Cytkit/cytkit/build_instructions/electronics1s1f.md

# Electronics: Cytkit model 1S-1F

## Mount FSC detector  {pagestep}

## Mount PMT detector {pagestep}

## LED flash calibration tool {pagestep}

## Sample pump stepper motor controller {pagestep}

## Sheath pump DC motor controller {pagestep}

## PMT power supply {pagestep}

## Picoscope {pagestep}

*** pic after set-up
