Cytkit/cytkit/build_instructions/electronics2s14f.md

# Electronics: Cytkit model 2S-14F

## FSC and SSC detectors  {pagestep}

## SiPM array (fluorescence) detector {pagestep}

## LED flash calibration tool {pagestep}

## Front panel OLED display {pagestep}

## Interlocks and connector boards {pagestep}

## Main board {pagestep}

## Power supply and USB connector {pagestep}

*** pics after set-up
