Cytkit/cytkit/build_instructions/images/build diagrams/optics/main body with optics - 1s1f.png

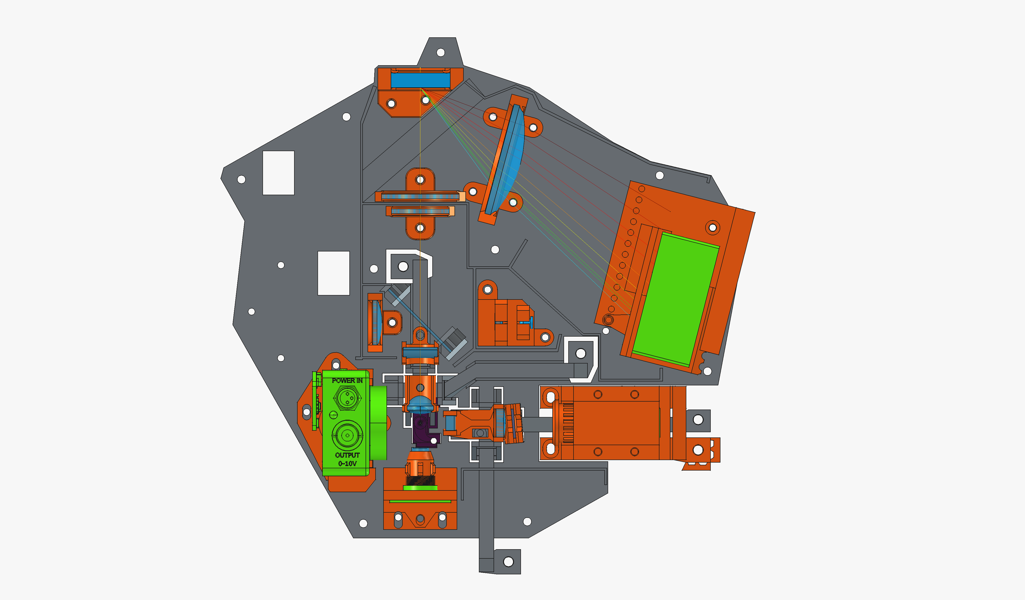
build_instructions/images/build diagrams/optics/main body with optics - 1s1f.png
