Cytkit/cytkit/build_instructions/images/build diagrams/optics/main body with optics - 2s14f - perspective2.png

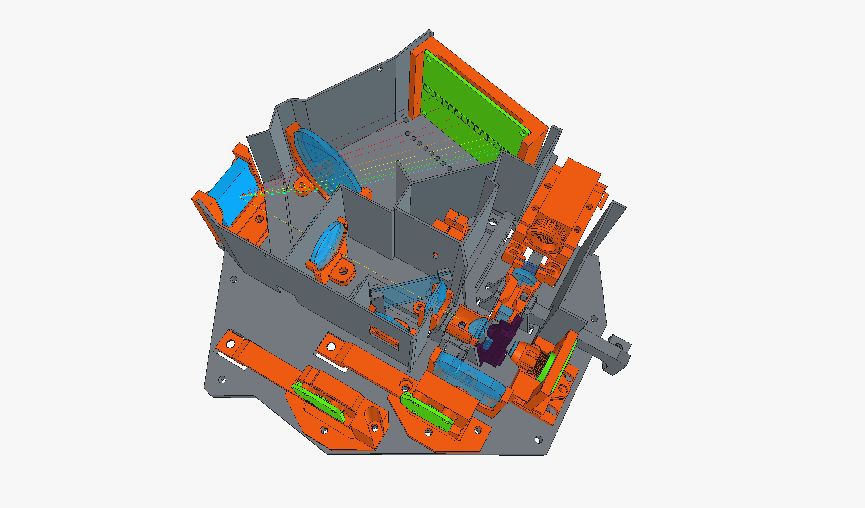
build_instructions/images/build diagrams/optics/main body with optics - 2s14f - perspective2.png
