Cytkit/cytkit/build_instructions/images/build diagrams/optics/main body with optics - 2s14f - without main body.png

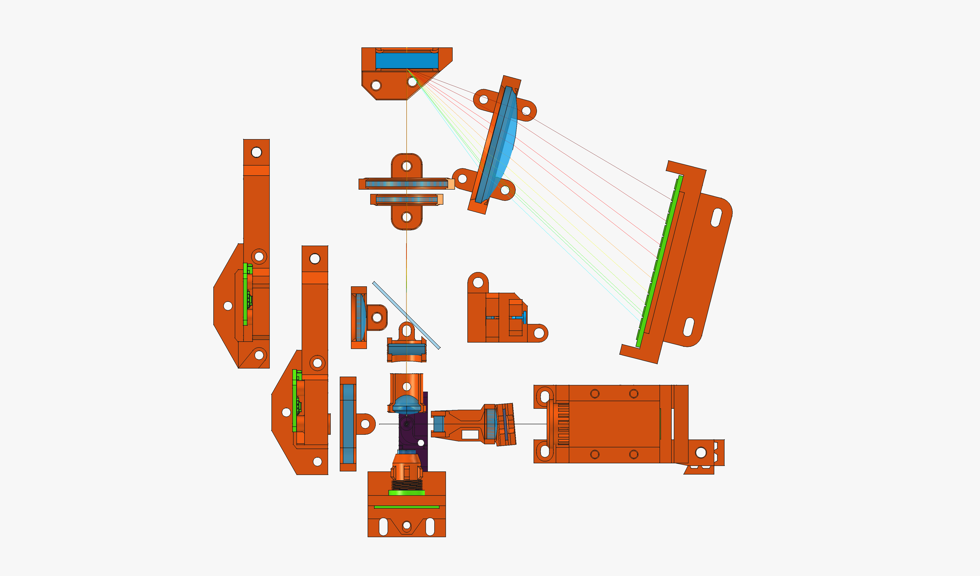
build_instructions/images/build diagrams/optics/main body with optics - 2s14f - without main body.png
