Cytkit/cytkit/build_instructions/images/build diagrams/optics/main body with optics - 2s14f.png

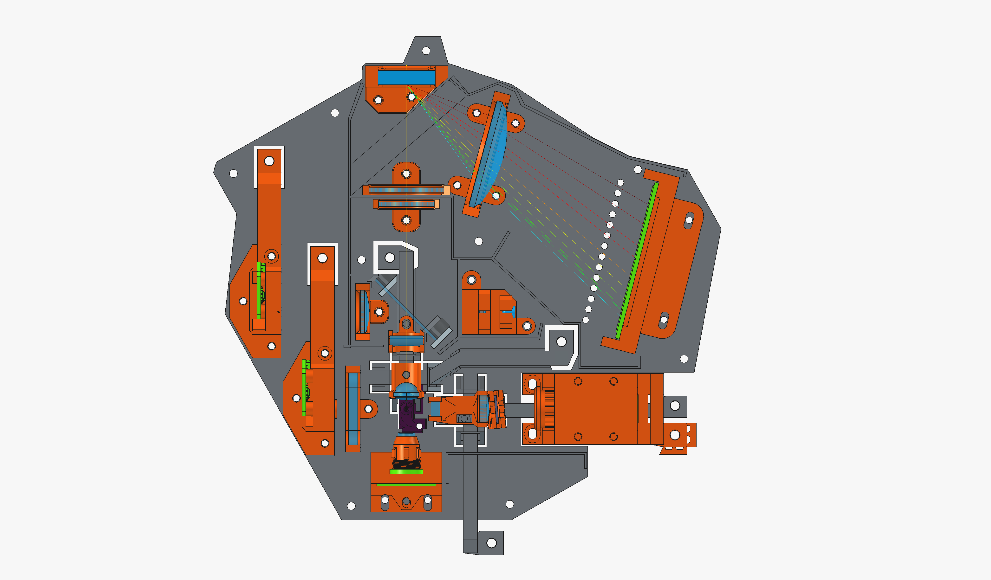
build_instructions/images/build diagrams/optics/main body with optics - 2s14f.png
