Cytkit/cytkit/build_instructions/printed/stl/main body with optics-fsc v slit 4mm.stl

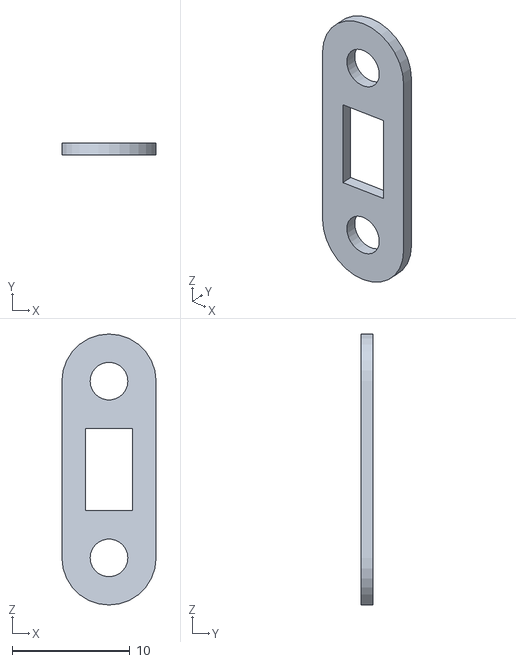
[picture p5: CAD file, 2026-11-09]
build_instructions/printed/stl/main body with optics-fsc v slit 4mm.stl
8.00 x 1.00 x 23.0
