Cytkit/cytkit/CAD and optical model/main body with optics.FCStd

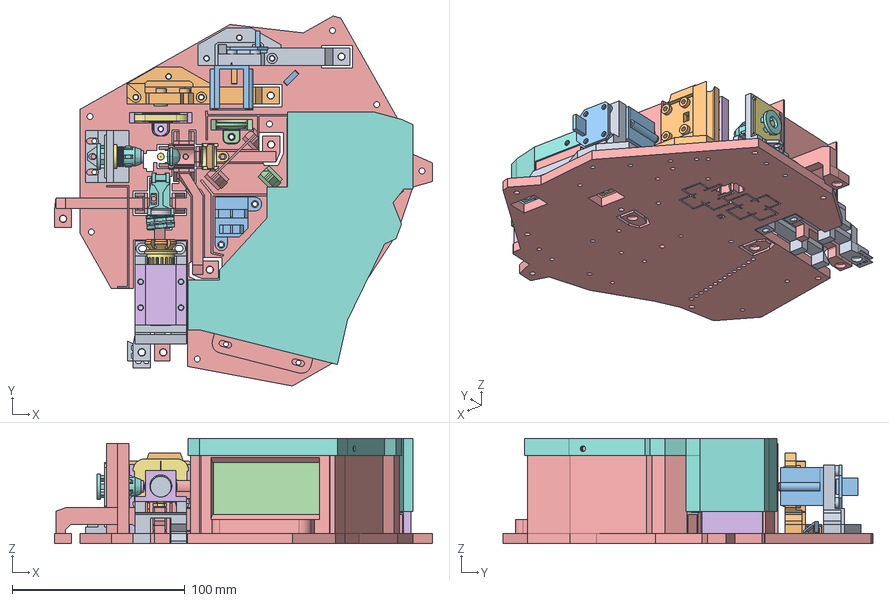
[picture p6: CAD file, 2026-11-09]
CAD and optical model/main body with optics.FCStd
219.1 x 214.4 x 61.0 mm
laser
Spectrum foc lens
Grating cube
PCB placeholder
laser collmating lens C775TMD-A - f = 4.0 mm, NA = 0.60, WD = 1.5 mm, Mounted Aspheric Lens, ARC: 350 - 700 nm
water
capillary quartz 4mm (round)
12X6mm Plano Convex Cylindrical Lens K9 Optical Glass Focal Length 27mm Center Thickness 4mm
Fused Silica 12.7mm Diameter Optical Plano Convex Lens Focal Length 50
corr cyl lens glass
SSC board
ssc foc lens f=50mm
dichroic filter 1
fsc foc lens aspherical od7
gopro filter
F8D12.7 aspherical condensing lens ACL 12708U CTN002243-E0W
bandpass
cable stay
cable stay 2
dichroic holder 2a
Main body
laser heat sink
lock nut
focusing lens holders
ssc holder
PD holder v adjust h slit
fsc h slit
fsc v slit 0.4mm
condensing lens holder
filter holder for fsc
corr cyl lens holder
fluorescence compartment cap
Holder Laser 25mW
colimating lens adjustment tool - short
LED holder for FL+SSC testing
ssc foc lens holder
Holder FL board - extra airflow to rear
Holder grating
Holder spec foc lens
Filter holder D34mm
Filter holder D25mm
Filter holder double D15mm
ssc h bar holder
ssc hbar 2mm
ssc hbar 1mm
ssc hbar 3mm
camera OV9726 25x30mm module
camera lens tube
camera focus mount - v adjust 2
