Cytkit/cytkit/build_instructions/printed/stl/main body with optics-Filter holder double D15mm.stl

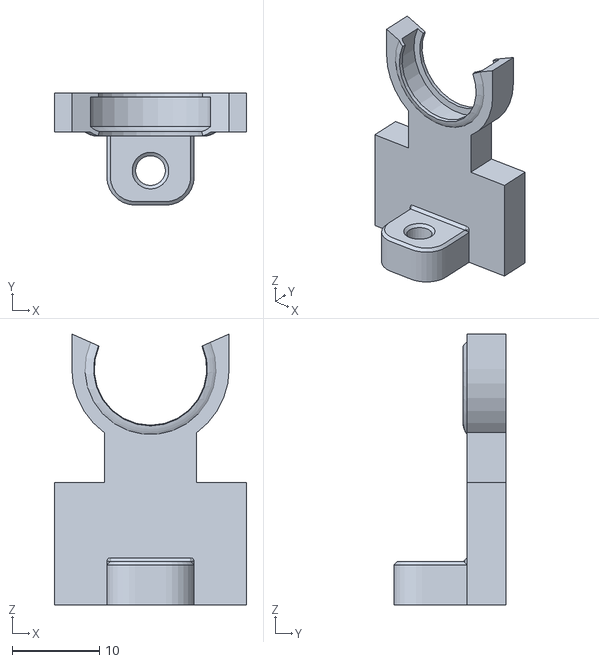
[picture p7: CAD file, 2026-11-09]
build_instructions/printed/stl/main body with optics-Filter holder double D15mm.stl
22.0 x 12.8 x 31.0
