Cytkit/cytkit/build_instructions/printed/stl/main body with optics-fsc v slit 2mm.stl

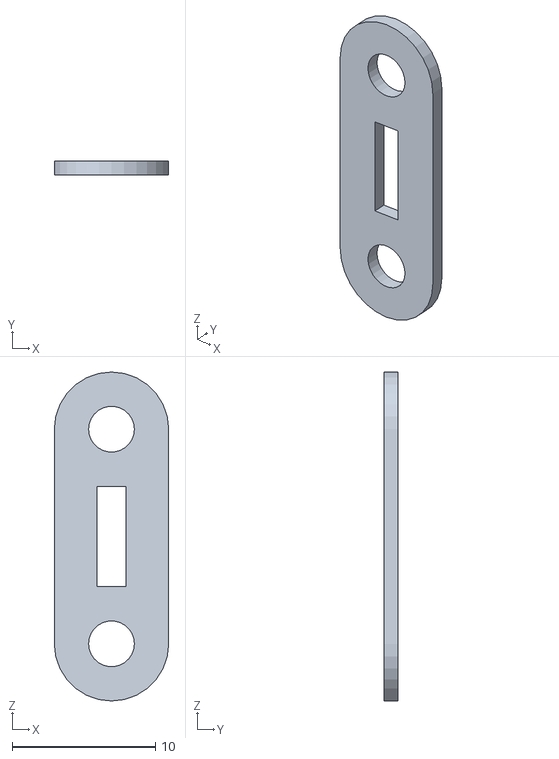
[picture p8: CAD file, 2026-11-09]
build_instructions/printed/stl/main body with optics-fsc v slit 2mm.stl
8.00 x 1.00 x 23.0
