Cytkit/cytkit/CAD and optical model/base panel cover stand cart.FCStd

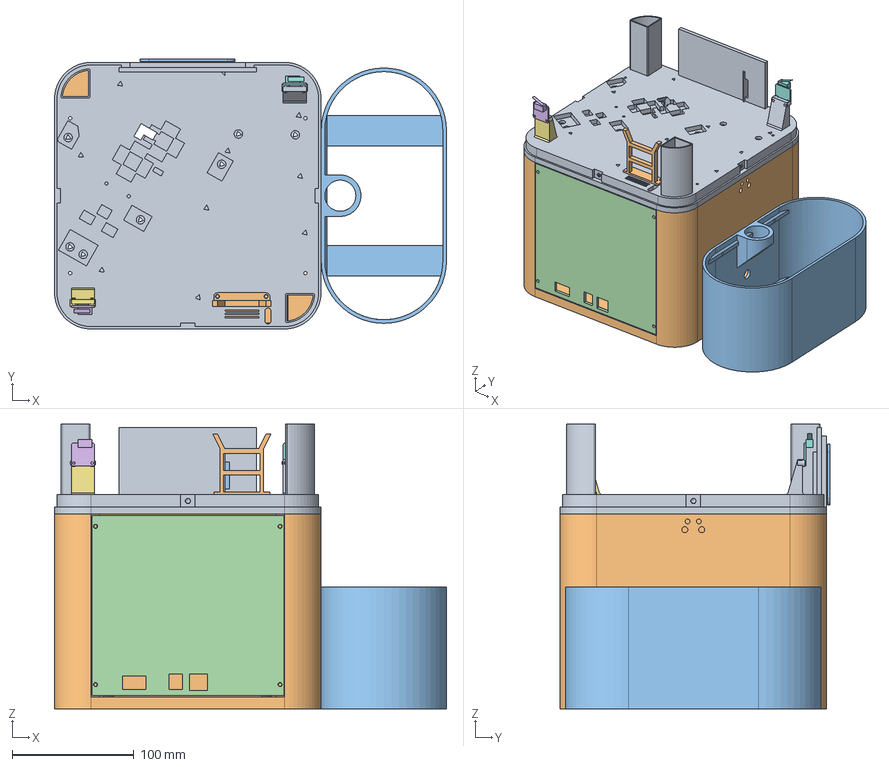
[picture p9: CAD file, 2026-11-09]
CAD and optical model/base panel cover stand cart.FCStd
322.0 x 221.8 x 234.0 mm
Base
Stand
Fluidics cart
rear panel
peristaltic pump holder flexi
interlock
interlock holder
interlock2
interlock holder 2
cable stay bar
Logo front panel
