Cytkit/cytkit/(list of files, cad)

Other CAD files:
CAD and optical model/Cytkit master assembly.FCStd
CAD and optical model/sample loader assembled.FCStd
