Cytkit/cytkit/build_instructions/fluidic/o-rings.md

---
PartData:
    Specs:
        Material: Nitrile (black)
        ID: 1 mm
        CS: 1 mm
    Suppliers:
        Seals R Us on eBay:
            PartNo: N/A
            Link: 'https://www.ebay.co.uk/itm/363833117691?var=633860823996'
---
# O-Rings (Nitrile, Black)

For sealing flow cell against cuvette on both ends.
