Cytkit/cytkit/build_instructions/images/build diagrams/optics/focus lens holder assembly.png

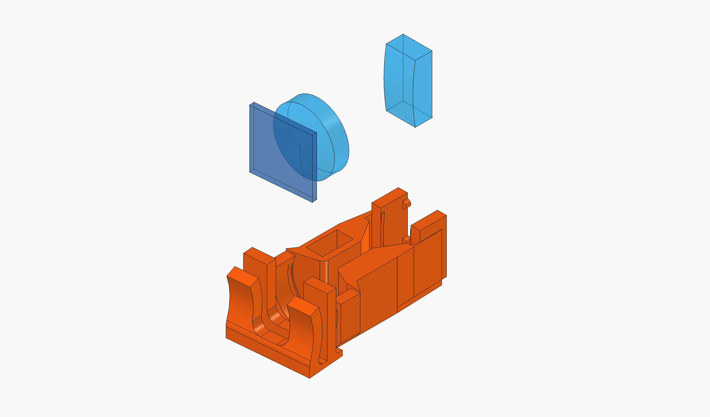
build_instructions/images/build diagrams/optics/focus lens holder assembly.png
