Cytkit/cytkit/build_instructions/images/build diagrams/optics/fsc detector assembly.png

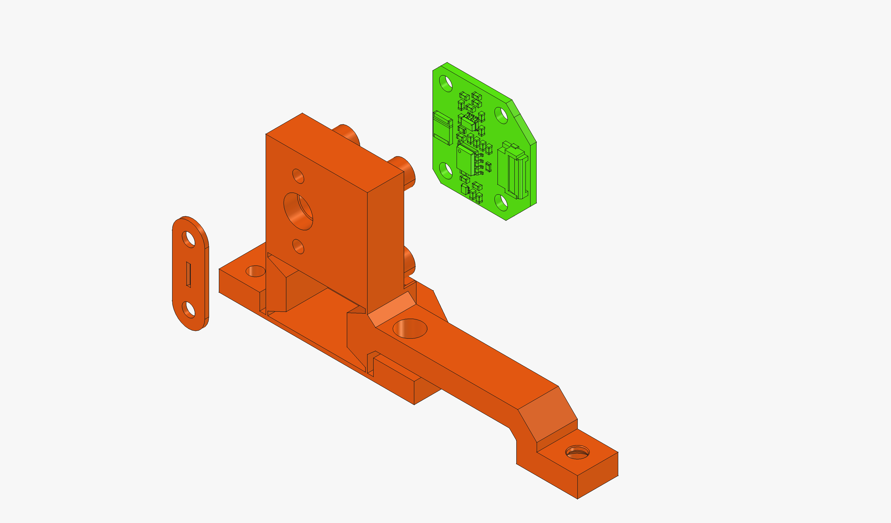
build_instructions/images/build diagrams/optics/fsc detector assembly.png
