Cytkit/cytkit/build_instructions/images/build diagrams/optics/laser assembly.png

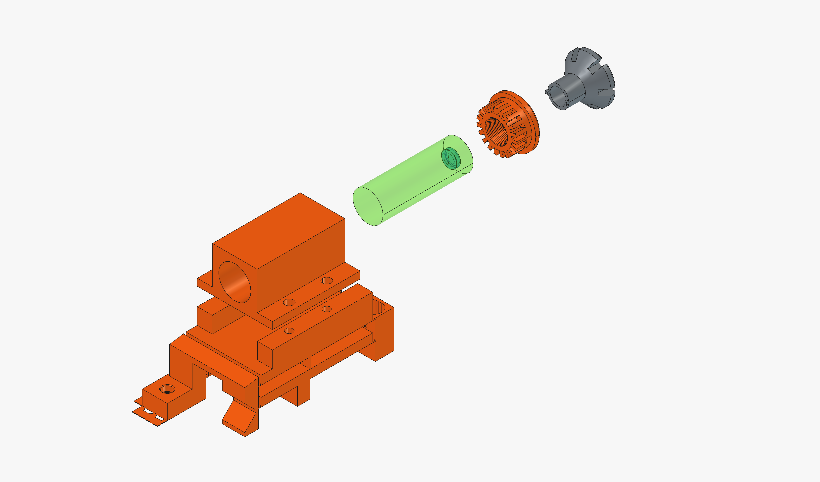
build_instructions/images/build diagrams/optics/laser assembly.png
