Cytkit/cytkit/build_instructions/images/build diagrams/optics/led flasher assembly.png

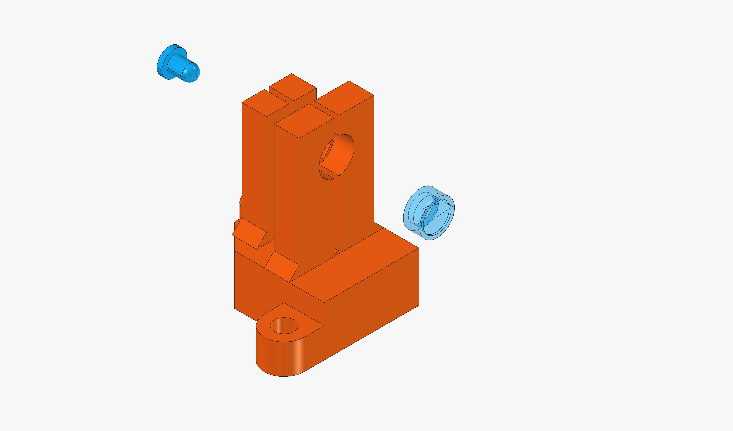
build_instructions/images/build diagrams/optics/led flasher assembly.png
