Cytkit/cytkit/build_instructions/images/build diagrams/optics/sipm detector assembly.png

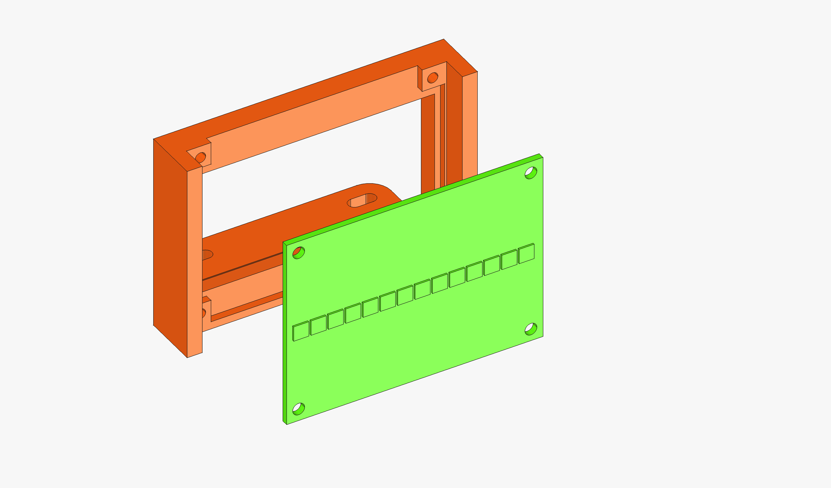
build_instructions/images/build diagrams/optics/sipm detector assembly.png
