Cytkit/cytkit/build_instructions/images/build diagrams/optics/ssc detector assembly.png

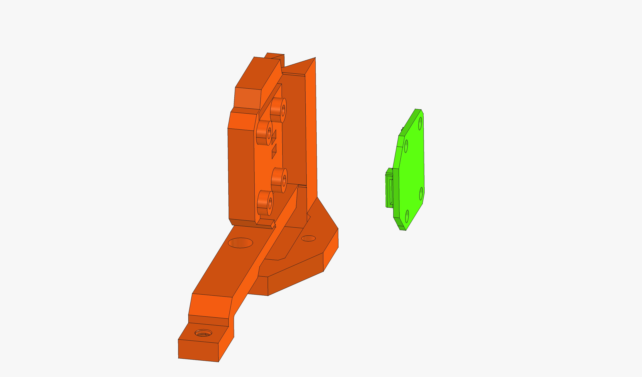
build_instructions/images/build diagrams/optics/ssc detector assembly.png
