Cytkit/cytkit/build_instructions/images/build photos/more photos/20260530_124508.jpg

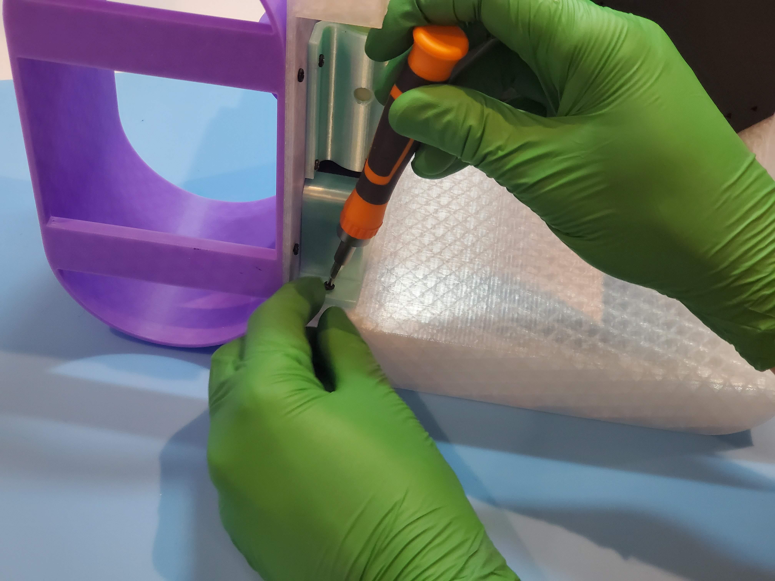
build_instructions/images/build photos/more photos/20260530_124508.jpg
