Cytkit/cytkit/build_instructions/images/build photos/more photos/20260530_144437.jpg

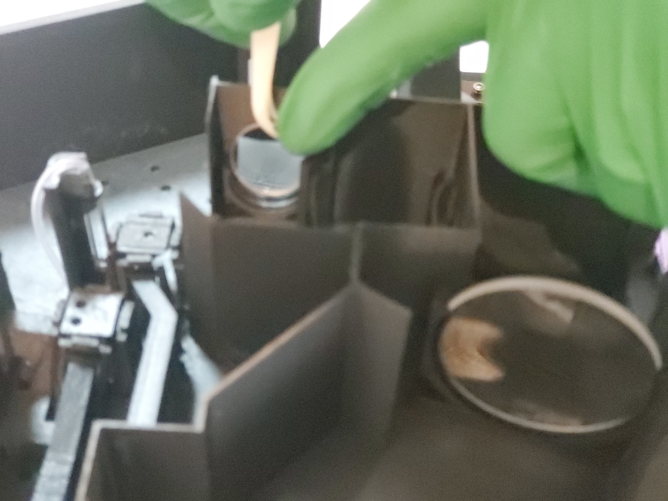
build_instructions/images/build photos/more photos/20260530_144437.jpg
