Cytkit/cytkit/build_instructions/images/build photos/more photos/20260530_145707.jpg

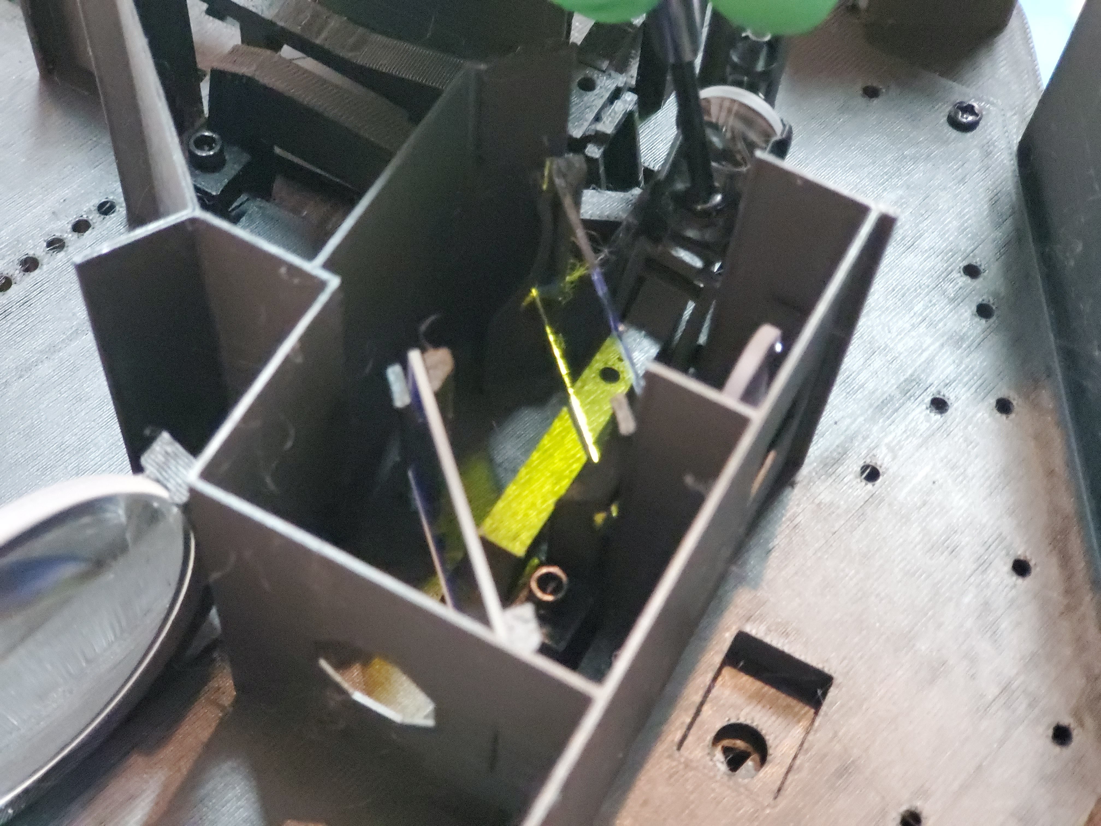
build_instructions/images/build photos/more photos/20260530_145707.jpg
