Cytkit/cytkit/build_instructions/images/build photos/more photos/20260530_151049.jpg

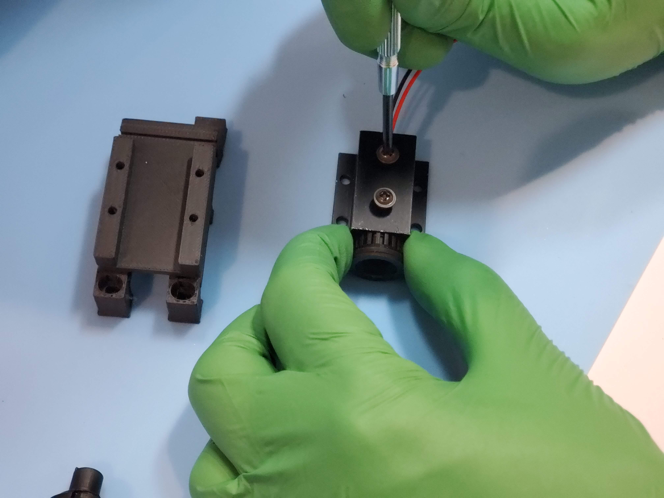
build_instructions/images/build photos/more photos/20260530_151049.jpg
