Cytkit/cytkit/build_instructions/images/build photos/more photos/20260530_152505.jpg

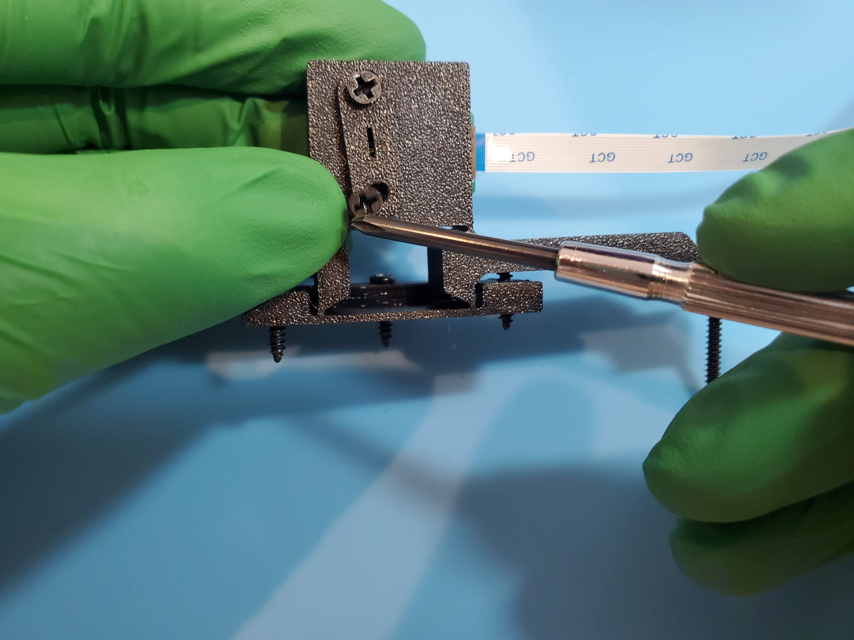
build_instructions/images/build photos/more photos/20260530_152505.jpg
