Cytkit/cytkit/build_instructions/images/build photos/more photos/20260530_154637.jpg

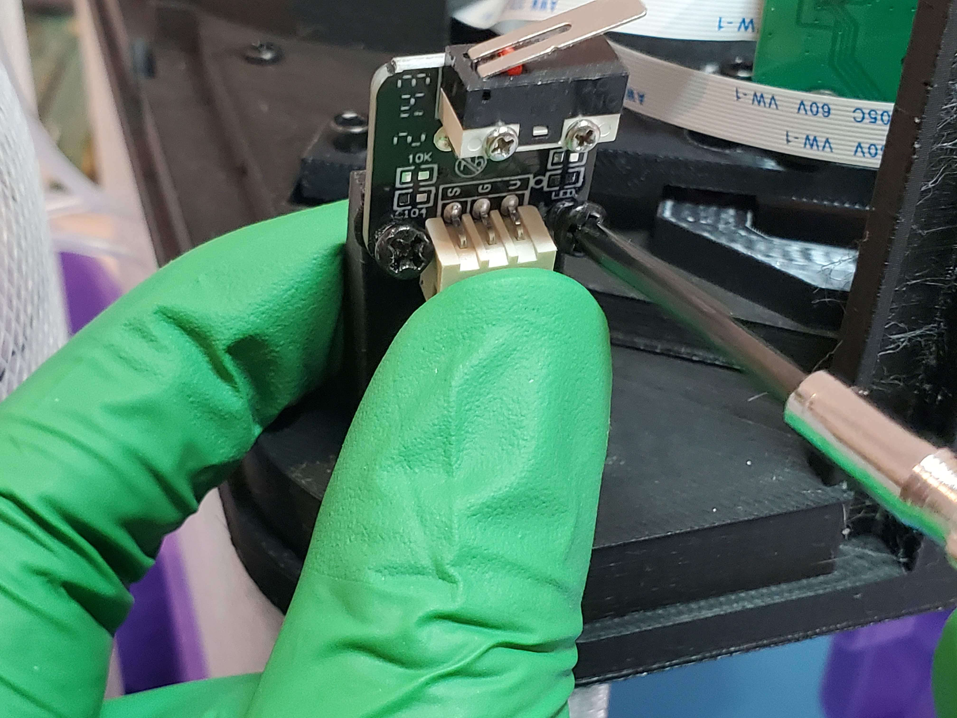
build_instructions/images/build photos/more photos/20260530_154637.jpg
