Cytkit/cytkit/build_instructions/images/build photos/more photos/20260530_172929.jpg

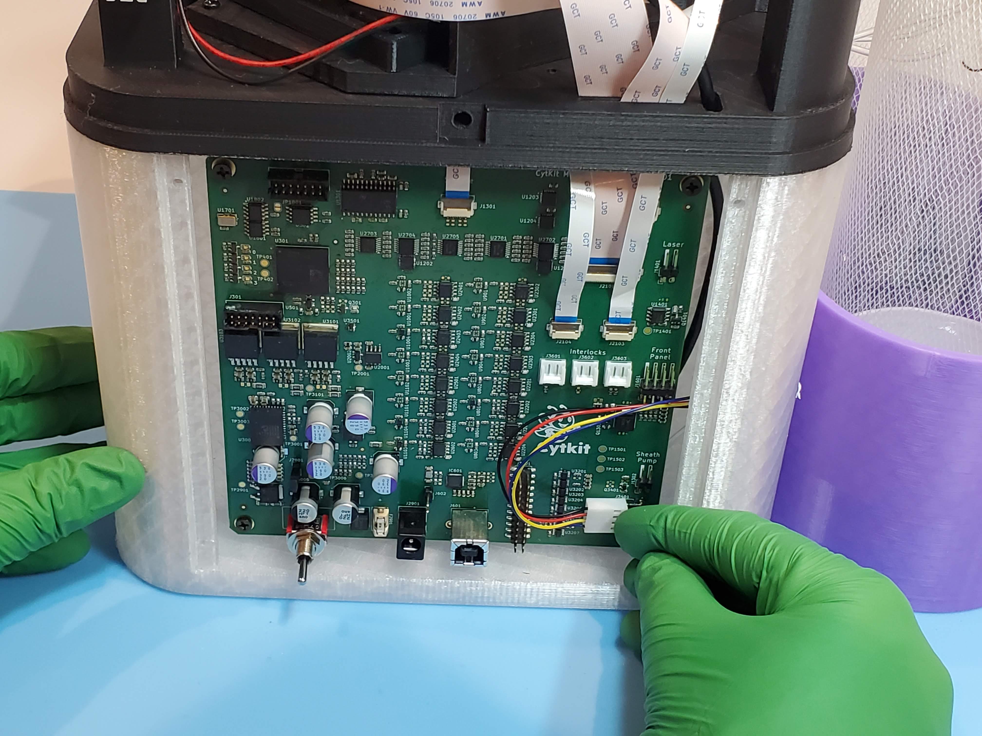
build_instructions/images/build photos/more photos/20260530_172929.jpg
