Cytkit/cytkit/build_instructions/images/build photos/more photos/20260530_173735.jpg

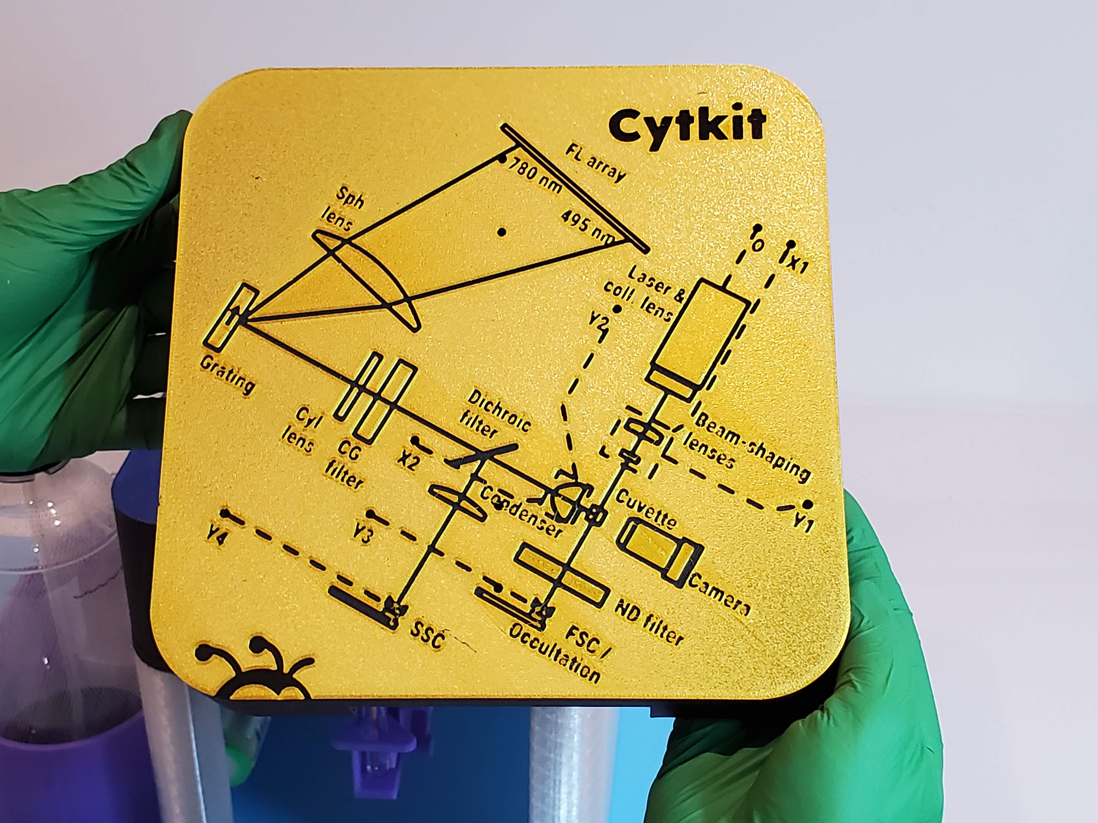
build_instructions/images/build photos/more photos/20260530_173735.jpg
