Cytkit/cytkit/build_instructions/images/build photos/more photos/20260530_181712.jpg

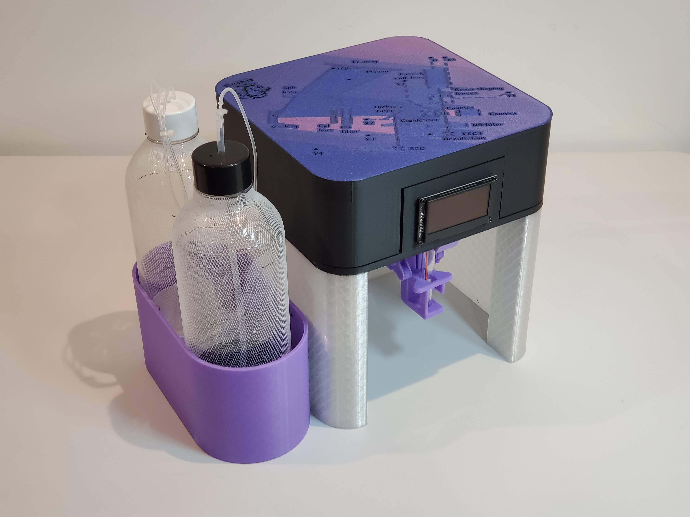
build_instructions/images/build photos/more photos/20260530_181712.jpg
