Cytkit/cytkit/build_instructions/images/build photos/more photos/20260531_122913.jpg

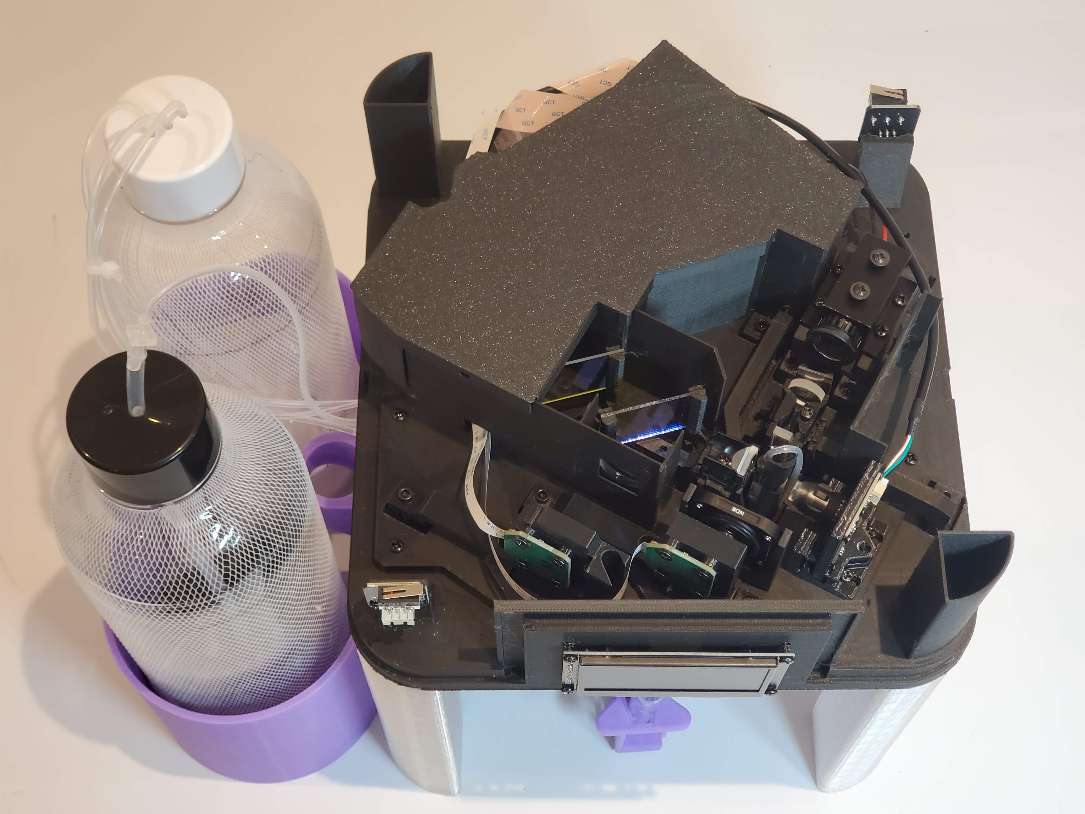
build_instructions/images/build photos/more photos/20260531_122913.jpg
