Cytkit/cytkit/build_instructions/images/build photos/more photos/20260531_122926.jpg

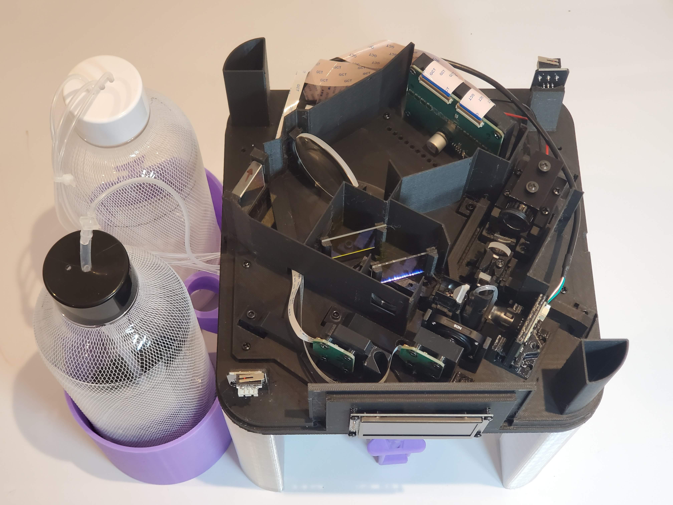
build_instructions/images/build photos/more photos/20260531_122926.jpg
