Cytkit/cytkit/build_instructions/images/build photos/more photos/20260531_170930.jpg

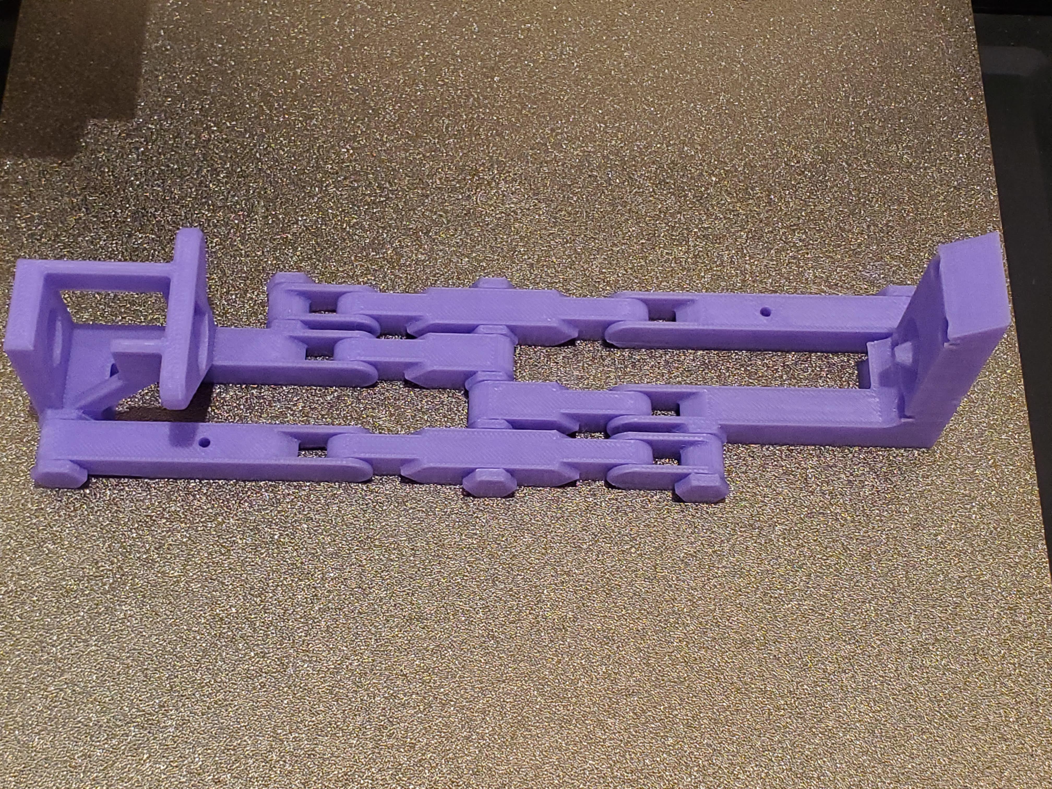
build_instructions/images/build photos/more photos/20260531_170930.jpg
