Cytkit/cytkit/build_instructions/images/build photos/more photos/20260602_085630.jpg

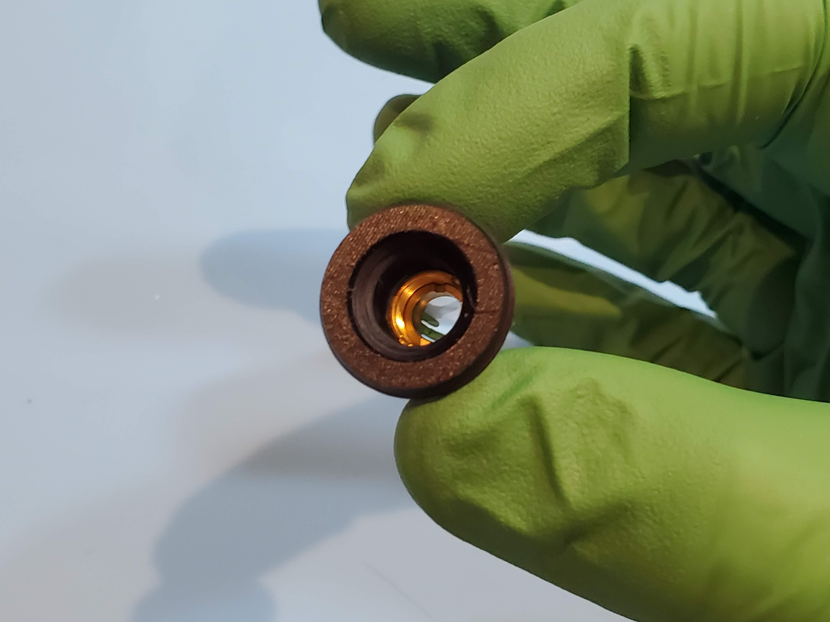
build_instructions/images/build photos/more photos/20260602_085630.jpg
