Cytkit/cytkit/build_instructions/images/build photos/more photos/20260602_085747.jpg

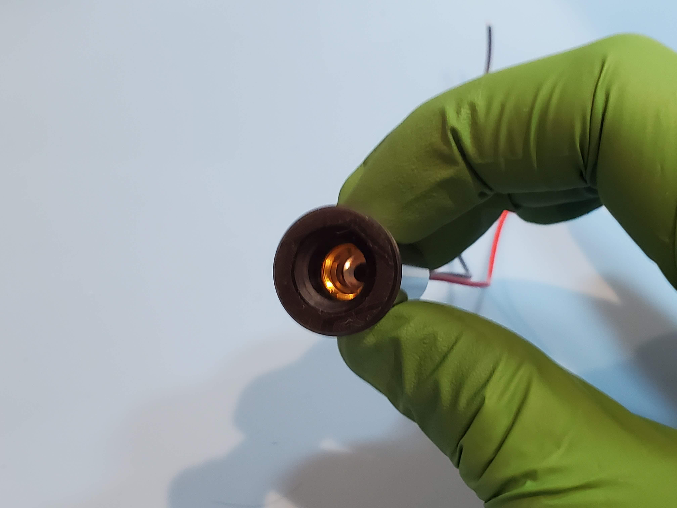
build_instructions/images/build photos/more photos/20260602_085747.jpg
