Cytkit/cytkit/build_instructions/images/build photos/more photos/20260928_152339.jpg

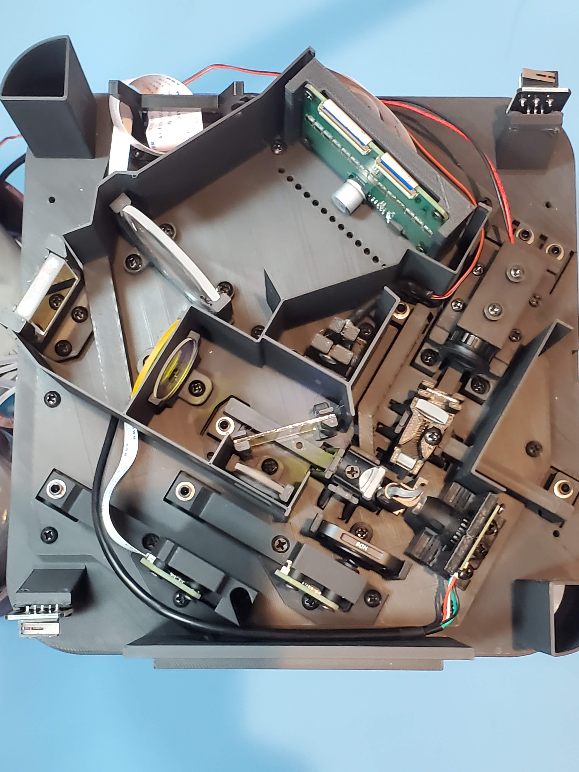
build_instructions/images/build photos/more photos/20260928_152339.jpg
