Cytkit/cytkit/build_instructions/mechanical/screws.yaml

self_tapping_m3x25_hex_socket:
    Name: M3 self-tapping hex socket cap screws 25 mm (black)
    Description: Metric Screw
    Specs:
        Material: Carbon Steel (Black)
        Thread: M3
        Length: 25 mm
        Cap: internal hex cap (Allen key)
    Suppliers:
        Aliexpress:
            PartNo: 15-50pcs Black Hex Hexagon Socket Cap Head Self Tapping Screws Carbon Steel
            Link: 'https://www.aliexpress.com/item/1005004723738740.html'
self_tapping_m3x6_posi:
    Name: M3 self-tapping posi head screws 6 mm (black)
    Description: Metric Screw
    Specs:
        Material: Carbon Steel (Black)
        Thread: M3
        Length: 6 mm
        Cap: Philips/Posi
    Suppliers:
        Aliexpress:
            PartNo: Black Carbon Steel Phillips Truss Head Screw
            Link: 'https://www.aliexpress.com/item/1005009495394483.html'
self_tapping_m3x8_posi:
    Name: M3 self-tapping posi head screws 8 mm (black)
    Description: Metric Screw
    Specs:
        Material: Carbon Steel (Black)
        Thread: M3
        Length: 8 mm
        Cap: Philips/Posi
    Suppliers:
        Aliexpress:
            PartNo: Black Carbon Steel Phillips Truss Head Screw
            Link: 'https://www.aliexpress.com/item/1005009495394483.html'
self_tapping_m3x10_posi:
    Name: M3 self-tapping posi head screws 10 mm (black)
    Description: Metric Screw
    Specs:
        Material: Carbon Steel (Black)
        Thread: M3
        Length: 10 mm
        Cap: Philips/Posi
    Suppliers:
        Aliexpress:
            PartNo: Black Carbon Steel Phillips Truss Head Screw
            Link: 'https://www.aliexpress.com/item/1005009495394483.html'
self_tapping_m3x12_posi:
    Name: M3 self-tapping posi head screws 12 mm (black)
    Description: Metric Screw
    Specs:
        Material: Carbon Steel (Black)
        Thread: M3
        Length: 12 mm
        Cap: Philips/Posi
    Suppliers:
        Aliexpress:
            PartNo: Black Carbon Steel Phillips Truss Head Screw
            Link: 'https://www.aliexpress.com/item/1005009495394483.html'
self_tapping_m3x16_posi:
    Name: M3 self-tapping posi head screws 16 mm (black)
    Description: Metric Screw
    Specs:
        Material: Carbon Steel (Black)
        Thread: M3
        Length: 16 mm
        Cap: Philips/Posi
    Suppliers:
        Aliexpress:
            PartNo: Black Carbon Steel Phillips Truss Head Screw
            Link: 'https://www.aliexpress.com/item/1005009495394483.html'
self_tapping_m2.6x6_posi:
    Name: M2.6 self-tapping posi head screws 6 mm (black)
    Description: Metric Screw
    Specs:
        Material: Carbon Steel (Black)
        Thread: M2.6
        Length: 6 mm
        Cap: Philips/Posi
    Suppliers:
        Aliexpress:
            PartNo: Black Carbon Steel Phillips Truss Head Screw
            Link: 'https://www.aliexpress.com/item/1005009495394483.html'
m3_washers:
    Name: M3 washers
    Description: Metric washer
    Specs:
        Material: Stainless Steel
        Inner diameter: 3 mm
        Cap: Philips/Posi
    Suppliers:
        Aliexpress:
            PartNo: DIN125 Plain Washers 304 Stainless Steel
            Link: 'https://www.aliexpress.com/item/1005011840506400.html'
